hazemmh1911/Sign_Language_Translator/WhatsApp Image 2021-07-11 at 11.14.03 PM.jpeg

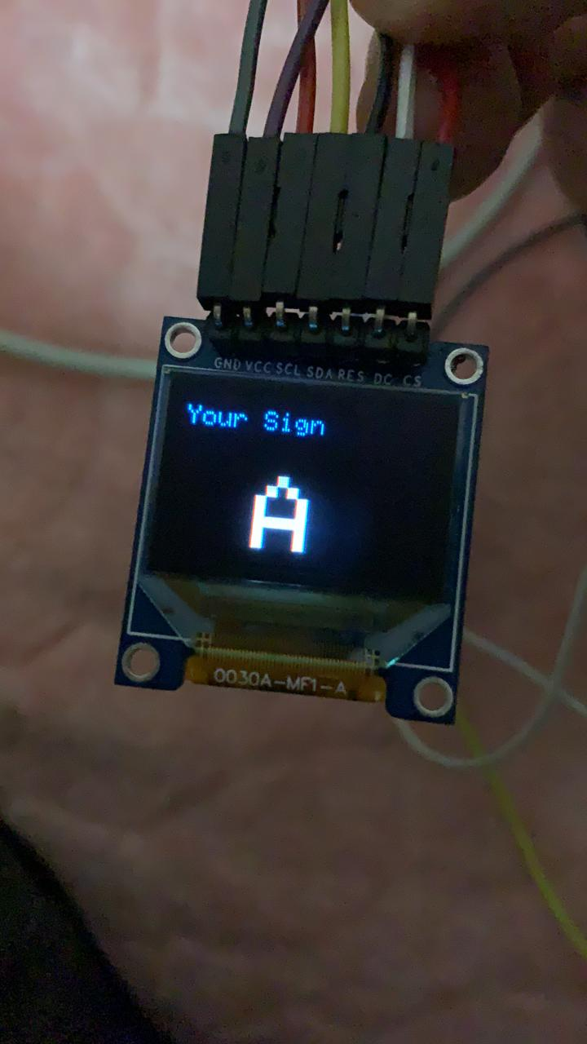
WhatsApp Image 2021-07-11 at 11.14.03 PM.jpeg
