hazemmh1911/Sign_Language_Translator/README.md

# Sign_Language_Translator
 
Our team Graduation project ,it uses arduino nano and processing 3 to translate a physical hardware signals into text on an oled and speech in a speaker.
