hazemmh1911/Sign_Language_Translator/Simulation+PCB(Eagle)/PCBtest_final.brd

## EAGLE design Simulation+PCB(Eagle)/PCBtest_final.brd (2021-07-22)

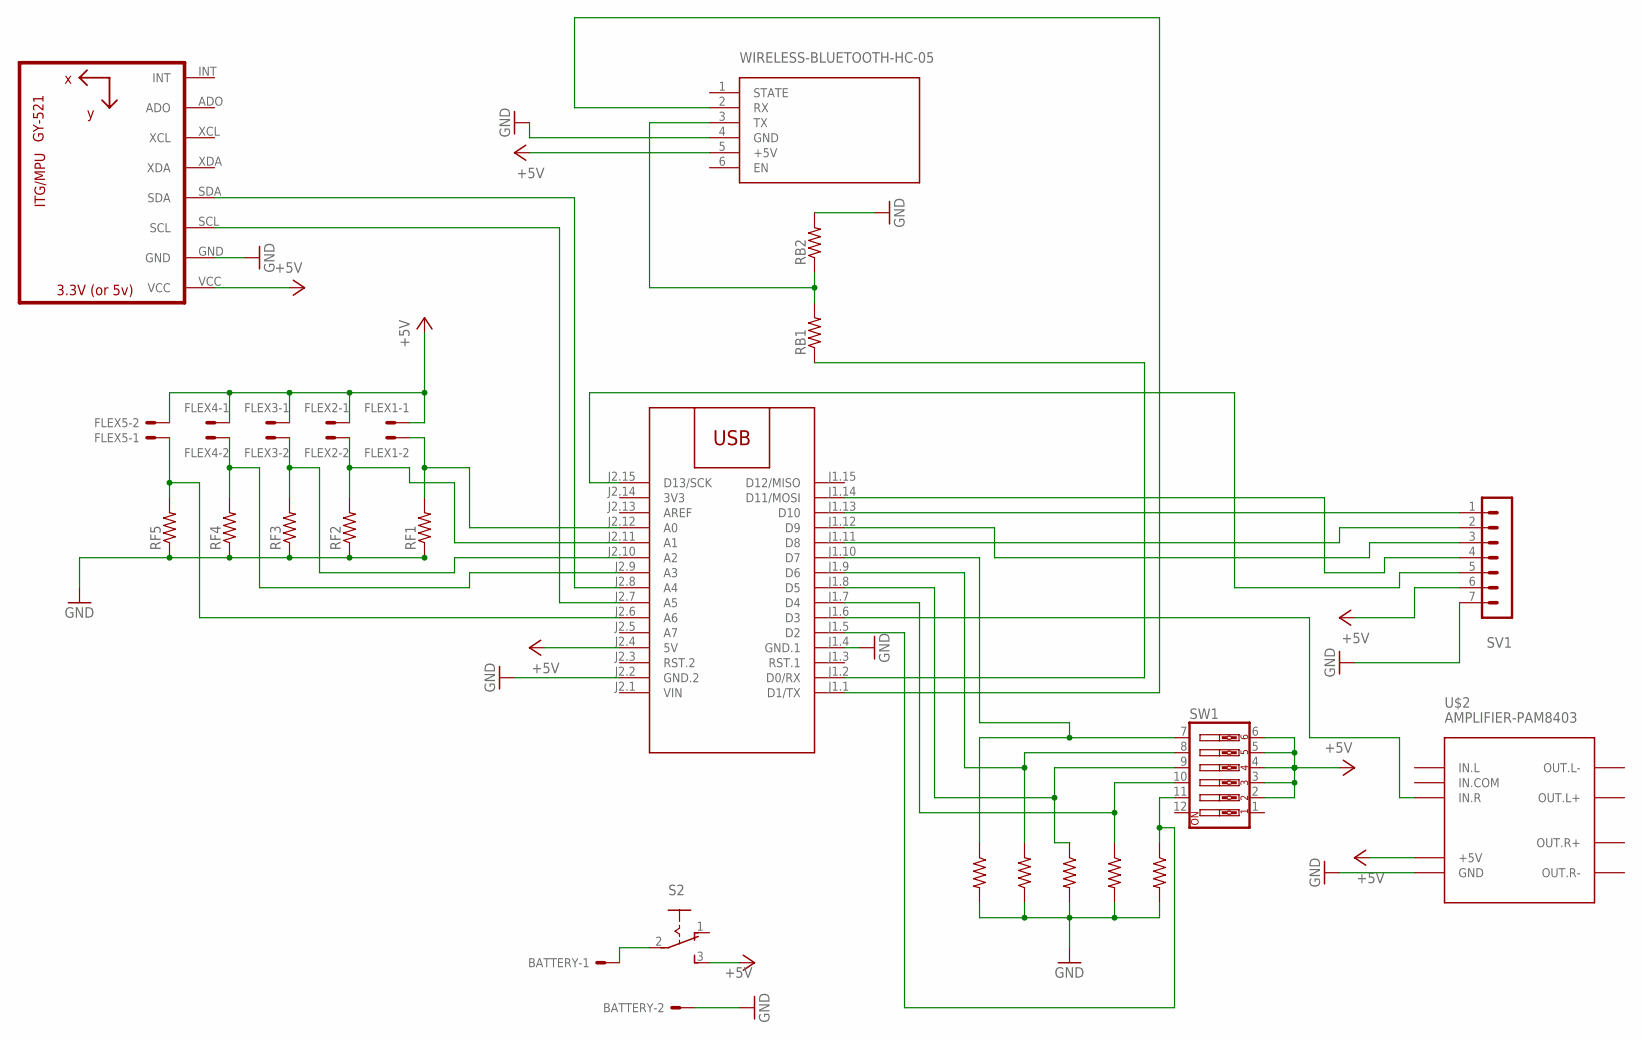
[picture p25: schematic PCBtest_2b.sch]

Parts:
BATTERY: 332-02
FLEX1, FLEX2, FLEX3, FLEX4, FLEX5: 332-02
M1: ARDUINO-NANO-3.0
RB1, RB2: R-US_0204/7; 0204/7
RF1, RF2, RF3, RF4, RF5: R-US_0204/7; 0204/7
RS1, RS2, RS3, RS4, RS5: R-US_0204/7; 0204/7
S2: 255SB
SV1: MA07-1
SW1: SW_DIP-6; EDG-06
U1: GY-521MPU6050; GY-521
U$1: WIRELESS-BLUETOOTH-HC-05
U$2: AMPLIFIER-PAM8403

Connections:
3V3: M1.J2.14 (3V3)
+5V: FLEX1.1, FLEX2.1, FLEX3.1, FLEX4.1, FLEX5.2, M1.J2.4 (5V), S2.3 (S), SV1.6, SW1.2, SW1.3, SW1.4, SW1.5, SW1.6, U1.VCC, U$1.5 (+5V), U$2.+5V
GND: BATTERY.2, M1.J1.4 (GND.1), M1.J2.2 (GND.2), RB2.2, RF1.1, RF2.1, RF3.1, RF4.1, RF5.1, RS1.2, RS2.2, RS3.2, RS4.1, RS5.2, SV1.7, U1.GND, U$1.4 (GND), U$2.GND
unnamed: M1.J1.5 (D2), RS1.1, SW1.11
unnamed: FLEX5.1, M1.J2.6 (A6), RF5.2
unnamed: M1.J1.8 (D5), RS3.1, SW1.9
unnamed: FLEX3.2, M1.J2.10 (A2), RF3.2
unnamed: M1.J2.8 (A4), U1.SDA
unnamed: M1.J2.7 (A5), U1.SCL
unnamed: RB1.2, RB2.1, U$1.3 (TX)
unnamed: FLEX1.2, M1.J2.12 (A0), RF1.2
unnamed: M1.J1.6 (D3), U$2.IN.R
unnamed: M1.J1.1 (D1/TX), U$1.2 (RX)
unnamed: M1.J1.2 (D0/RX), RB1.1
unnamed: M1.J1.9 (D6), RS4.2, SW1.8
unnamed: FLEX4.2, M1.J2.9 (A3), RF4.2
unnamed: M1.J1.13 (D10), SV1.1
unnamed: FLEX2.2, M1.J2.11 (A1), RF2.2
unnamed: M1.J1.11 (D8), SV1.2
unnamed: M1.J1.12 (D9), SV1.3
unnamed: BATTERY.1, S2.2
unnamed: M1.J1.14 (D11/MOSI), SV1.4
unnamed: M1.J2.15 (D13/SCK), SV1.5
unnamed: M1.J1.10 (D7), RS5.1, SW1.7
unnamed: M1.J1.7 (D4), RS2.1, SW1.10
VIN: M1.J2.1 (VIN)

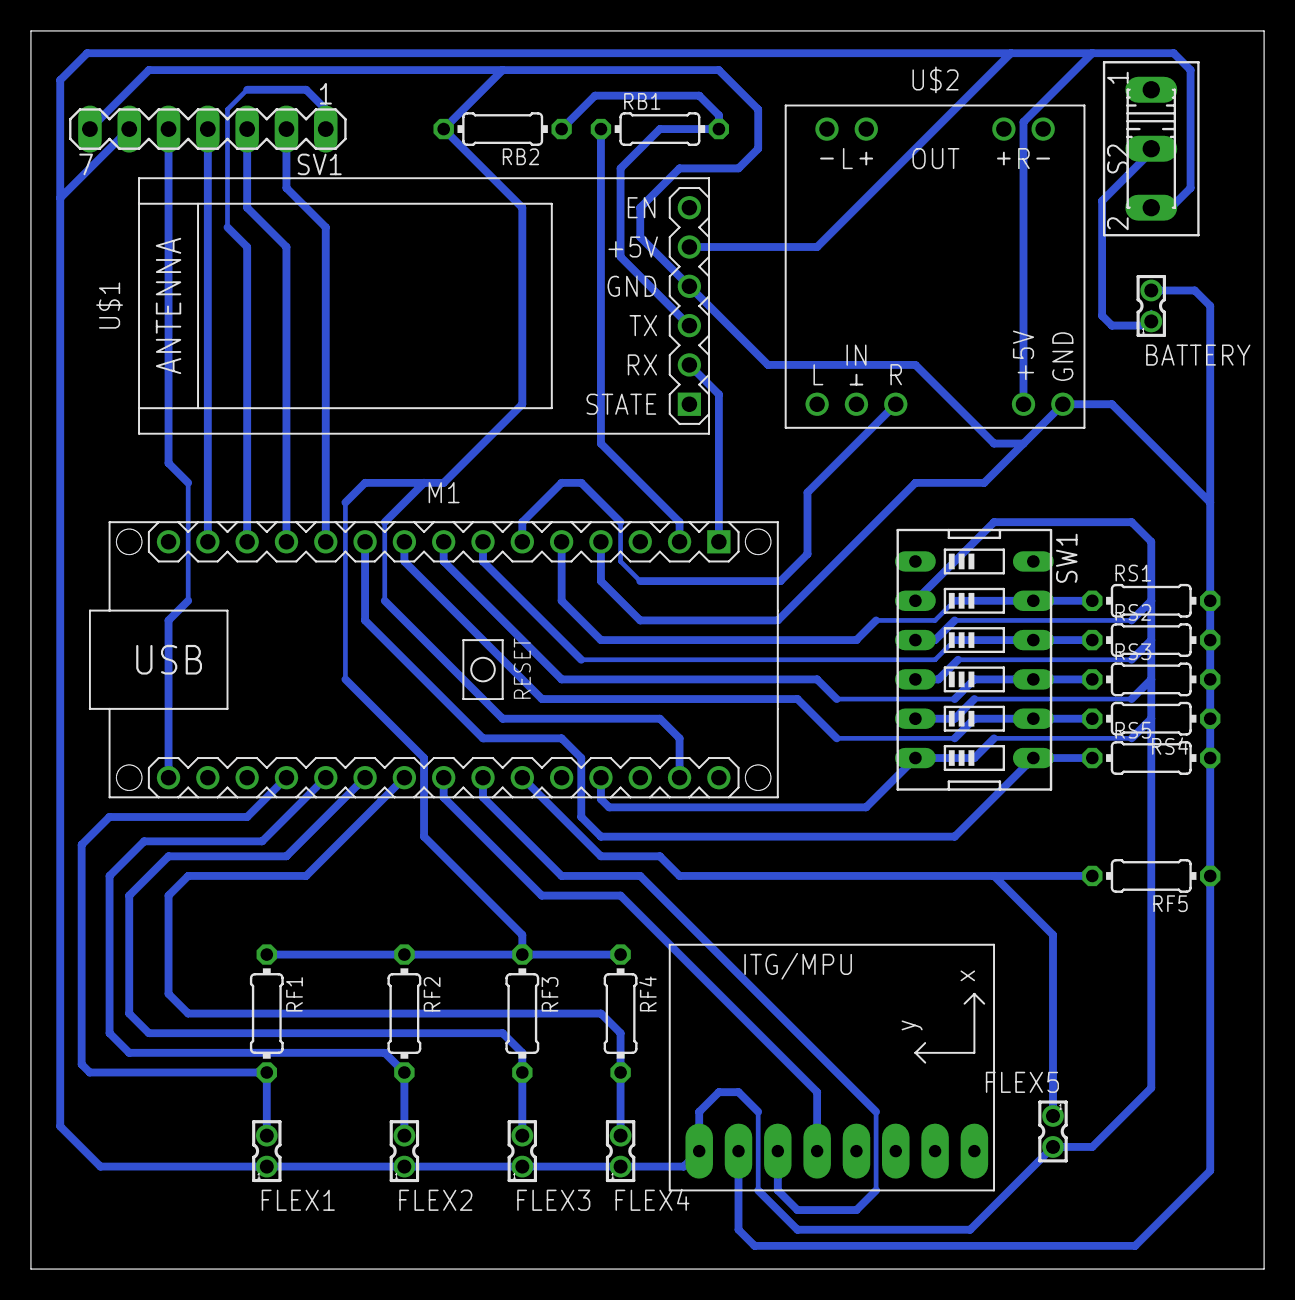
[picture p26: board PCBtest_final.brd from above]

Board: 2 copper layers, 79.7 x 80.0 mm, 25 parts (0 on the bottom side), 24 nets.
