hazemmh1911/Sign_Language_Translator/Codeing/Arduino_Code/Project_final/Privet_defiens.h

// ================================================================
// ===                      FLEX DECLERATION                    ===
// ================================================================
int thumb=0;
int index=1;
int mid=2;
int ring=3;
int pinky=6;
int index_reading;
int mid_reading;
int ring_reading;
int pinky_reading;
int thumb_reading;

// ================================================================
// ===                    THUMB CALIBRATION                     ===
// ================================================================
#define Fbind_thumb thumb_reading<=220
#define Hbind_thumb (thumb_reading>=225)&&(thumb_reading<=255)
#define Stright_thumb thumb_reading>=260

// ================================================================
// ===                    INDEX CALIBRATION                     ===
// ================================================================
#define Fbind_index index_reading<=230
#define Hbind_index (index_reading>=235)&&(index_reading<=380)
#define Stright_index index_reading>=390

// ================================================================
// ===                    MIDDLE CALIBRATION                    ===
// ================================================================
#define Fbind_mid mid_reading<=200
#define Hbind_mid (mid_reading>=205)&&(mid_reading<=275)
#define Stright_mid mid_reading>=280

// ================================================================
// ===                     RING CALIBRATION                     ===
// ================================================================
#define Fbind_ring ring_reading<=240
#define Hbind_ring (ring_reading>=245)&&(ring_reading<=375)
#define Stright_ring ring_reading>=380

// ================================================================
// ===                    PINKY CALIBRATION                     ===
// ================================================================
#define Fbind_pinky pinky_reading<=200
#define Hbind_pinky (pinky_reading>=205)&&(pinky_reading<=295)
#define Stright_pinky pinky_reading>=300

// ================================================================
// ===                    NUMBERS CALIBRATION                   ===
// ================================================================
#define Zero 	  (Hbind_index)   && (Hbind_mid)   && (Hbind_ring)   && (Hbind_pinky)   && (Hbind_thumb)
#define One		  (Stright_index) && (Fbind_mid)   && (Fbind_ring)   && (Fbind_pinky)   && (Fbind_thumb)
#define Two		  (Stright_index) && (Stright_mid) && (Hbind_ring)   && (Fbind_pinky)   && (Fbind_thumb)
#define Three 	(Stright_index) && (Stright_mid) && (Fbind_ring)   && (Fbind_pinky)   && (Stright_thumb)
#define Four	  (Stright_index) && (Stright_mid) && (Stright_ring) && (Stright_pinky) && (Fbind_thumb)
#define Five	  (Stright_index) && (Stright_mid) && (Stright_ring) &&(Stright_pinky)  && (Stright_thumb)
#define Six		  (Stright_index) && (Stright_mid) && (Stright_ring) && (Fbind_pinky)   && (Hbind_thumb)
#define Seven	  (Stright_index) && (Stright_mid) && (Fbind_ring)   && (Stright_pinky) && (Fbind_thumb)
#define Eight	  (Stright_index) && (Fbind_mid)   && (Stright_ring) && (Stright_pinky) && (Fbind_thumb)
#define Nine	  (Fbind_index)   && (Stright_mid) && (Stright_ring) && (Stright_pinky) && (Fbind_thumb)

// ================================================================
// ===               ENGLISH CHARACTERS CALIBRATION             ===
// ================================================================
#define CharA	(Fbind_index)    && (Fbind_mid)    && (Fbind_ring)   && (Fbind_pinky)   && (Stright_thumb)
#define CharB	(Stright_index)  && (Stright_mid)  && (Stright_ring) && (Stright_pinky) && (Fbind_thumb)
#define	CharC	(Hbind_index)    && (Hbind_mid)    && (Hbind_ring)   && (Hbind_pinky)   && (Stright_thumb)
#define	CharD	(Stright_index)  && (Fbind_mid)    && (Hbind_ring)   && (Hbind_pinky)   && (Hbind_thumb)
#define	CharE	(Hbind_index)    && (Hbind_mid)    && (Hbind_ring)   && (Hbind_pinky)   && (Fbind_thumb)
#define CharF	(Fbind_index)    && (Stright_mid)  && (Stright_ring) && (Stright_pinky) && (Fbind_thumb)
#define CharG	(Stright_index)  && (Fbind_mid)    && (Fbind_ring)   && (Fbind_pinky)   && (Stright_thumb)  && (y<30)  && (z<150)
#define CharH	(Stright_index)  && (Stright_mid)  && (Fbind_ring)   && (Fbind_pinky)   && (Stright_thumb)
#define CharI	(Fbind_index)    && (Fbind_mid)    && (Fbind_ring)   && (Stright_pinky) && (Fbind_thumb)    && (x>250)
#define CharJ	(Fbind_index)    && (Fbind_mid)    && (Fbind_ring)   && (Stright_pinky) && (Fbind_thumb)    && (x<250)
#define CharK	(Stright_index)  && (Stright_mid)  && (Hbind_ring)   && (Fbind_pinky)   && (Stright_thumb)
#define CharL	(Stright_index)  && (Fbind_mid)    && (Fbind_ring)   && (Fbind_pinky)   && (Stright_thumb)  && (y>30)
#define CharM	(Hbind_index)    && (Fbind_mid)    && (Fbind_ring)   && (Fbind_pinky)   && (Stright_thumb)
#define CharN	(Hbind_index)    && (Hbind_mid)    && (Fbind_ring)   && (Fbind_pinky)   && (Stright_thumb)
#define CharO	(Hbind_index)    && (Hbind_mid)    && (Hbind_ring)   && (Hbind_pinky)   && (Hbind_thumb)
#define CharP	(Stright_index)  && (Hbind_mid)    && (Hbind_ring)   && (Hbind_pinky)   && (Stright_thumb)
#define CharQ	(Stright_index)  && (Fbind_mid)    && (Fbind_ring)   && (Fbind_pinky)   && (Stright_thumb)  && (z<150)
#define CharR	(Stright_index)  && (Stright_mid)  && (Fbind_ring)   && (Hbind_pinky)   && (Hbind_thumb)
#define CharS	(Fbind_index)    && (Fbind_mid)    && (Fbind_ring)   && (Fbind_pinky)   && (Fbind_thumb)
#define CharT	(Hbind_index)    && (Fbind_mid)    && (Fbind_ring)   && (Fbind_pinky)   && (Hbind_thumb)
#define CharU	(Stright_index)  && (Stright_mid)  && (Hbind_ring)   && (Hbind_pinky)   && (Hbind_thumb)
#define CharV	(Stright_index)  && (Stright_mid)  && (Hbind_ring)   && (Fbind_pinky)   && (Hbind_thumb)
#define	CharW	(Stright_index)  && (Stright_mid)  && (Stright_ring) && (Hbind_pinky)   && (Hbind_thumb)
#define	CharX	(Hbind_index)    && (Fbind_mid)    && (Fbind_ring)   && (Fbind_pinky)   && (Fbind_thumb)
#define CharY	(Fbind_index)    && (Fbind_mid)    && (Fbind_ring)   && (Stright_pinky) && (Stright_thumb)
#define CharZ	(Stright_index)  && (Fbind_mid)    && (Fbind_ring)   && (Fbind_pinky)   && (Fbind_thumb)

// ================================================================
// ===                ARABIC CHARACTERS CALIBRATION             ===
// ================================================================
#define AChar_ALF     (Fbind_index)    && (Fbind_mid)   && (Fbind_ring)   && (Fbind_pinky)    && (Stright_thumb)
#define	AChar_BAA     (Stright_index)  && (Fbind_mid)   && (Fbind_ring)   && (Fbind_pinky)    && (Hbind_thumb)
#define	AChar_TAA     (Stright_index)  && (Stright_mid) && (Fbind_ring)   && (Fbind_pinky)    && (Hbind_thumb)
#define	AChar_THA     (Stright_index)  && (Stright_mid) && (Stright_ring) && (Fbind_pinky)    && (Hbind_thumb)
#define	AChar_GEM     (Hbind_index)    && (Hbind_mid)   && (Hbind_ring)   && (Hbind_pinky)    && (Fbind_thumb)
#define	AChar_HAA     (Hbind_index)    && (Hbind_mid)   && (Hbind_ring)   && (Hbind_pinky)    && (Hbind_thumb)
#define	AChar_KHA     (Hbind_index)    && (Hbind_mid)   && (Hbind_ring)   && (Hbind_pinky)    && (Stright_thumb)
#define	AChar_DAL     (Stright_index)  && (Fbind_mid)   && (Fbind_ring)   && (Fbind_pinky)    && (Stright_thumb)  && (y<60)
#define	AChar_ZAL     (Stright_index)  && (Stright_mid) && (Fbind_ring)   && (Fbind_pinky)    && (Hbind_thumb)
#define AChar_RAA     (Hbind_index)    && (Fbind_mid)   && (Fbind_ring)   && (Fbind_pinky)    && (Fbind_thumb)
#define	AChar_ZAY     (Hbind_index)    && (Hbind_mid)   && (Fbind_ring)   && (Fbind_pinky)    && (Fbind_thumb)
#define	AChar_SEN     (Stright_index)  && (Stright_mid) && (Stright_ring) && (Stright_pinky)  && (Stright_thumb)
#define AChar_SHN     (Stright_index)  && (Stright_mid) && (Stright_ring) && (Hbind_pinky)    && (Stright_thumb)
#define	AChar_SAD     (Fbind_index)    && (Fbind_mid)   && (Fbind_ring)   && (Fbind_pinky)    && (Fbind_thumb)
#define	AChar_DAD     (Fbind_index)    && (Fbind_mid)   && (Fbind_ring)   && (Fbind_pinky)    && (Hbind_thumb)
#define AChar_TA      (Stright_index)  && (Hbind_mid)   && (Fbind_ring)   && (Fbind_pinky)    && (Hbind_thumb)
#define	AChar_ZA      (Stright_index)  && (Hbind_mid)   && (Fbind_ring)   && (Fbind_pinky)    && (Stright_thumb)
#define	AChar_EEN     (Stright_index)  && (Stright_mid) && (Fbind_ring)   && (Fbind_pinky)    && (Fbind_thumb)
#define AChar_GEN     (Stright_index)  && (Stright_mid) && (Fbind_ring)   && (Fbind_pinky)    && (Stright_thumb)
#define	AChar_FAA	    (Hbind_index)    && (Fbind_mid)   && (Fbind_ring)   && (Fbind_pinky)    && (Hbind_thumb)
#define AChar_QAF     (Hbind_index)    && (Hbind_mid)   && (Fbind_ring)   && (Fbind_pinky)    && (Hbind_thumb)
#define AChar_KAF     (Stright_index)  && (Stright_mid) && (Stright_ring) && (Stright_pinky)  && (Fbind_thumb
#define AChar_LAM     (Stright_index)  && (Fbind_mid)   && (Fbind_ring)   && (Fbind_pinky)    && (Stright_thumb)   && (y>60)
#define AChar_MEM     (Fbind_index)    && (Fbind_mid)   && (Fbind_ring)   && (Stright_pinky)  && (Fbind_thumb)
#define AChar_NON     (Hbind_index)    && (Fbind_mid)   && (Fbind_ring)   && (Fbind_pinky)    && (Stright_thumb)
#define AChar_HA      (Stright_index)  && (Stright_mid) && (Stright_ring) && (Stright_pinky)  && (Hbind_thumb)
#define AChar_WAW     (Hbind_index)    && (Hbind_mid)   && (Hbind_ring)   && (Fbind_pinky)    && (Stright_thumb)
#define AChar_YAA     (Fbind_index)    && (Fbind_mid)   && (Fbind_ring)   && (Stright_pinky)  && (Stright_thumb)

// ================================================================
// ===               ENGLISH WORDS CALIBRATION             ===
// ================================================================
#define HELLO  (Stright_index)    && (Stright_mid)    && (Stright_ring)   && (Stright_pinky)   && (Stright_thumb)
#define YES    (Fbind_index)      && (Fbind_mid)      && (Fbind_ring)     && (Fbind_pinky)     && (Hbind_thumb)
#define NO     (Stright_index)    && (Stright_mid)    && (Fbind_ring)     && (Fbind_pinky)     && (Stright_thumb)

// ================================================================
// ===               ARABIC WORDS CALIBRATION             ===
// ================================================================
#define A_HELLO  (Stright_index)    && (Stright_mid)    && (Stright_ring)   && (Stright_pinky)   && (Stright_thumb)
#define A_YES    (Fbind_index)      && (Fbind_mid)      && (Fbind_ring)     && (Fbind_pinky)     && (Hbind_thumb)
#define A_NO     (Stright_index)    && (Stright_mid)    && (Fbind_ring)     && (Fbind_pinky)     && (Stright_thumb)

// ================================================================
// ===                    SOUNDS DECLIRATION                    ===
// ================================================================
const uint8_t spZERO[]      PROGMEM = {0xA2,0x2B,0x20,0x2D,0xAA,0x1A,0xAA,0xB6,0x81,0xD4,0x88,0x72,0xAC,0x80,0x8F,0xC4,0x34,0x90,0xAA,0x8F,0x44,0xD5,0x43,0x4D,0xCB,0x16,0x33,0x8C,0xB6,0x44,0x23,0x9A,0xDC,0x21,0xA7,0x6B,0xAD,0x60,0x28,0x83,0x9C,0x9E,0x75,0x82,0x69,0x12,0x74,0xB2,0xD1,0xF1,0x87,0x74,0xAA,0x89,0x46,0x27,0x18,0x36,0x39,0x5C,0x17,0x9D,0x60,0xA8,0x92,0x34,0x5B,0xB4,0xA2,0xA6,0xCA,0xD2,0x7D,0xD1,0x88,0x73,0xB6,0xF2,0xA8,0x96,0x23,0xCD,0x83,0x4D,0x23,0x5D,0xB7,0x2C,0x0F,0x74,0xF3,0xC8,0xDC,0x8A,0x5C,0xA9,0xA4,0x3B,0x55,0xAB,0x73,0xE5,0xE2,0x3A,0xD7,0x6D,0x2C,0x49,0x8B,0x3D,0x6F,0x95,0xB1,0x78,0x4D,0xD7,0x78,0x94,0xA6,0x64,0xC3,0x33,0xE2,0x52,0x9A,0x92,0x8D,0x08,0xF3,0x4B,0x61,0x4A,0x31,0xDC,0xB8,0x26,0xBB,0x25,0x05,0x77,0x95,0x7A,0xF4,0x06,0x06};
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
// ===                SWITCHES DECLERATION                      ===
// ================================================================
char  Numbers_swt    =7;
char  E_Letters_swt  =6;
char  E_Words_swt    =5;
char  A_Letters_swt  =4;
char  A_Words_swt    =2;

#define   Numbers      1
#define   E_Letters    2
#define   A_Letters    3
#define   E_Words      4
#define   A_Words      5
#define   None         0

#define Numbers_Mode   (Num_Reading==HIGH) && (E_Letters_Reading==LOW)  && (E_Words_Reading==LOW)  && (A_Letters_Reading==LOW)  && (A_Words_Reading==LOW)
#define E_Letters_Mode (Num_Reading==LOW)  && (E_Letters_Reading==HIGH) && (E_Words_Reading==LOW)  && (A_Letters_Reading==LOW)  && (A_Words_Reading==LOW)
#define E_Words_Mode   (Num_Reading==LOW)  && (E_Letters_Reading==LOW)  && (E_Words_Reading==HIGH) && (A_Letters_Reading==LOW)  && (A_Words_Reading==LOW)
#define A_Letters_Mode (Num_Reading==LOW)  && (E_Letters_Reading==LOW)  && (E_Words_Reading==LOW)  && (A_Letters_Reading==HIGH) && (A_Words_Reading==LOW)
#define A_Words_Mode   (Num_Reading==LOW)  && (E_Letters_Reading==LOW)  && (E_Words_Reading==LOW)  && (A_Letters_Reading==LOW)  && (A_Words_Reading==HIGH)
